TriEverthing/WCH-Link_Tool/WCH-Link-R1-1v1/Hardware/Production/bom.csv

Designator | Footprint | Quantity | Value | LCSC Part #
C1, C19, C3 | 0603 | 3 | 22uF,0603,6.3V
C18, C2, C4, C5, C7 | 0402 | 5 | 0.1uF,0402,25V
D1 | 0402 | 1 | RED
D2 | 0402 | 1 | BLUE
F1 | 0603 | 1 | Fuse
H1, H2, H3, H4 | MountingHole_2.2mm_M2_Pad_Via | 4 | MountingHole_Pad
JP1 | IDC-Header_2x05_P2.54mm_Mid | 1 | Conn_02x05_Odd_Even
L1 | L_Sunlord_SWPA252012S | 1 | 2.2uH
M1, M2, M3 | Fiducial_0.5mm_Mask1mm | 3 | Fiducial
Q1 | SOT-23 | 1 | SI2301
Q2, Q4 | SOT-23 | 2 | SI2302
R1, R2, R5, R6, R7, R9 | 0402 | 6 | 100ohm,0402,5%
R10, R8 | 0402 | 2 | 270ohm,0402,5%
R11 | 0402 | 1 | 4.7kohm,0402,5%
R12 | 0402 | 1 | 470ohm,0402,5%
R13, R15 | 0402 | 2 | 15kohm,0402,5%
R14, R17 | 0402 | 2 | 5.1kohm,0402,5%
R16 | 0402 | 1 | 68kohm,0402,5%
R3, R4 | 0402 | 2 | 1kohm,0402,5%
S2 | SW_Push_SPST_NO_Alps_SKRK | 1 | SW_Push
SW1 | SW_DIP_SPSTx01_Slide_Copal_CHS-01B_W7.62mm_P1.27mm | 1 | SW_DIP_x01
U1 | QFN-28-1EP_4x4mm_P0.4mm_EP2.6x2.6mm_ThermalVias | 1 | CH459F
U2 | SOT-23-5 | 1 | RY3408
USB1 | USB_C_Receptacle_Palconn_UTC16-G | 1 | Type-C-16pin
