TriEverthing/WCH-Link_Tool/WCH-LinkE-R0-1v3/Hardware/Production/bom.csv

Designator | Footprint | Quantity | Value | LCSC Part #
C1, C19, C3 | 0603 | 3 | 22uF,0603,6.3V
C10, C18, C2, C4, C5, C6, C9 | 0402 | 7 | 0.1uF,0402,25V
C7, C8 | 0402 | 2 | 20pF,0402,50V
D1 | 0402 | 1 | RED
D2 | 0402 | 1 | BLUE
H1, H2, H3, H4 | MountingHole_2.2mm_M2_Pad_Via | 4 | MountingHole_Pad
JP1 | IDC-Header_2x05_P2.54mm_Mid | 1 | Conn_02x05_Odd_Even
L1 | L_Sunlord_SWPA252012S | 1 | 2.2uH
M1, M2, M3 | Fiducial_0.5mm_Mask1mm | 3 | Fiducial
R1, R5 | 0402 | 2 | 6.8kohm,0402,5%
R10, R8 | 0402 | 2 | 270ohm,0402,5%
R11, R12 | 0402 | 2 | 4.7kohm,0402,5%
R13, R14, R19, R7, R9 | 0402 | 5 | 100ohm,0402,5%
R15 | 0402 | 1 | 15kohm,0402,5%
R16 | 0402 | 1 | 68kohm,0402,5%
R17, R18 | 0402 | 2 | 5.1kohm,0402,5%
R2, R3, R4 | 0402 | 3 | 1kohm,0402,5%
RT1 | TestPoint_Pad_D0.6 | 1 | TestPoint
S1, S2 | SW_Push_SPST_NO_Alps_SKRK | 2 | SW_Push
U1 | TSSOP-20_4.4x6.5mm_P0.65mm | 1 | ~
U2 | SOT-23-5 | 1 | RY3408
U3, U4 | SOT-23-6 | 2 | CH217A
USB1 | USB_C_Receptacle_Palconn_UTC16-G | 1 | Type-C-16pin
Y1 | Crystal_SMD_3225-4Pin_3.2x2.5mm | 1 | 12HMz,3325
