TriEverthing/WCH-Link_Tool/WCH-LinkW-R0-1v1/Hardware/Production/bom.csv

Designator | Footprint | Quantity | Value | LCSC Part #
C1, C3 | 0603 | 2 | 22uF,0603,6.3V
C10, C11, C12, C2, C4, C5, C6, C9 | 0402 | 8 | 0.1uF,0402,25V
C13, C14 | 0402 | 2 | 1uF,0402,16V
C15, C16 | 0402 | 2 | 1.8pF,0402,50V
D1, D3 | 0402 | 2 | RED
D2 | 0402 | 1 | BLUE
D4, D5 | D_SOD-323 | 2 | 1N5819
E1 | ANT-F-7-2.4G-1.6mmFR4 | 1 | Antenna_PCB
H1, H2 | MountingHole_2.2mm_M2_Pad_Via | 2 | MountingHole_Pad
JP1 | IDC-Header_2x05_P2.54mm_Mid | 1 | Conn_02x05_Odd_Even
L1 | L_Sunlord_SWPA252012S | 1 | 2.2uH
L2 | 0402 | 1 | 1.8nH,0402
M1, M2, M3 | Fiducial_0.5mm_Mask1mm | 3 | Fiducial
R1, R5 | 0402 | 2 | 6.8kohm,0402,5%
R10, R8 | 0402 | 2 | 270ohm,0402,5%
R11, R9 | 0402 | 2 | 5.1kohm,0402,5%
R12, R2, R3, R4, R6 | 0402 | 5 | 1kohm,0402,5%
R15 | 0402 | 1 | 15kohm,0402,5%
R16 | 0402 | 1 | 68kohm,0402,5%
R7 | 0402 | 1 | 100ohm,0402,5%
RN1 | R_Array_Concave_4x0402 | 1 | 100ohm,0402x4,5%
S1, S2 | SW_Push_SPST_NO_Alps_SKRK | 2 | SW_Push
U1 | QFN-28-1EP_4x4mm_P0.4mm_EP2.8x2.8mm_ThermalVias | 1 | CH32V208G
U2 | SOT-23-5 | 1 | RY3408
U3, U4 | SOT-23-6 | 2 | CH217A
USB1 | USB_C_Receptacle_Palconn_UTC16-G | 1 | Type-C-16pin
Y1 | Crystal_SMD_3225-4Pin_3.2x2.5mm | 1 | 32HMz,3325
