TriEverthing/WCH-Link_Tool/WCH-Link-R1-1v1/Hardware/Schmeatic/WCH-Link-R1-1v1.pdf

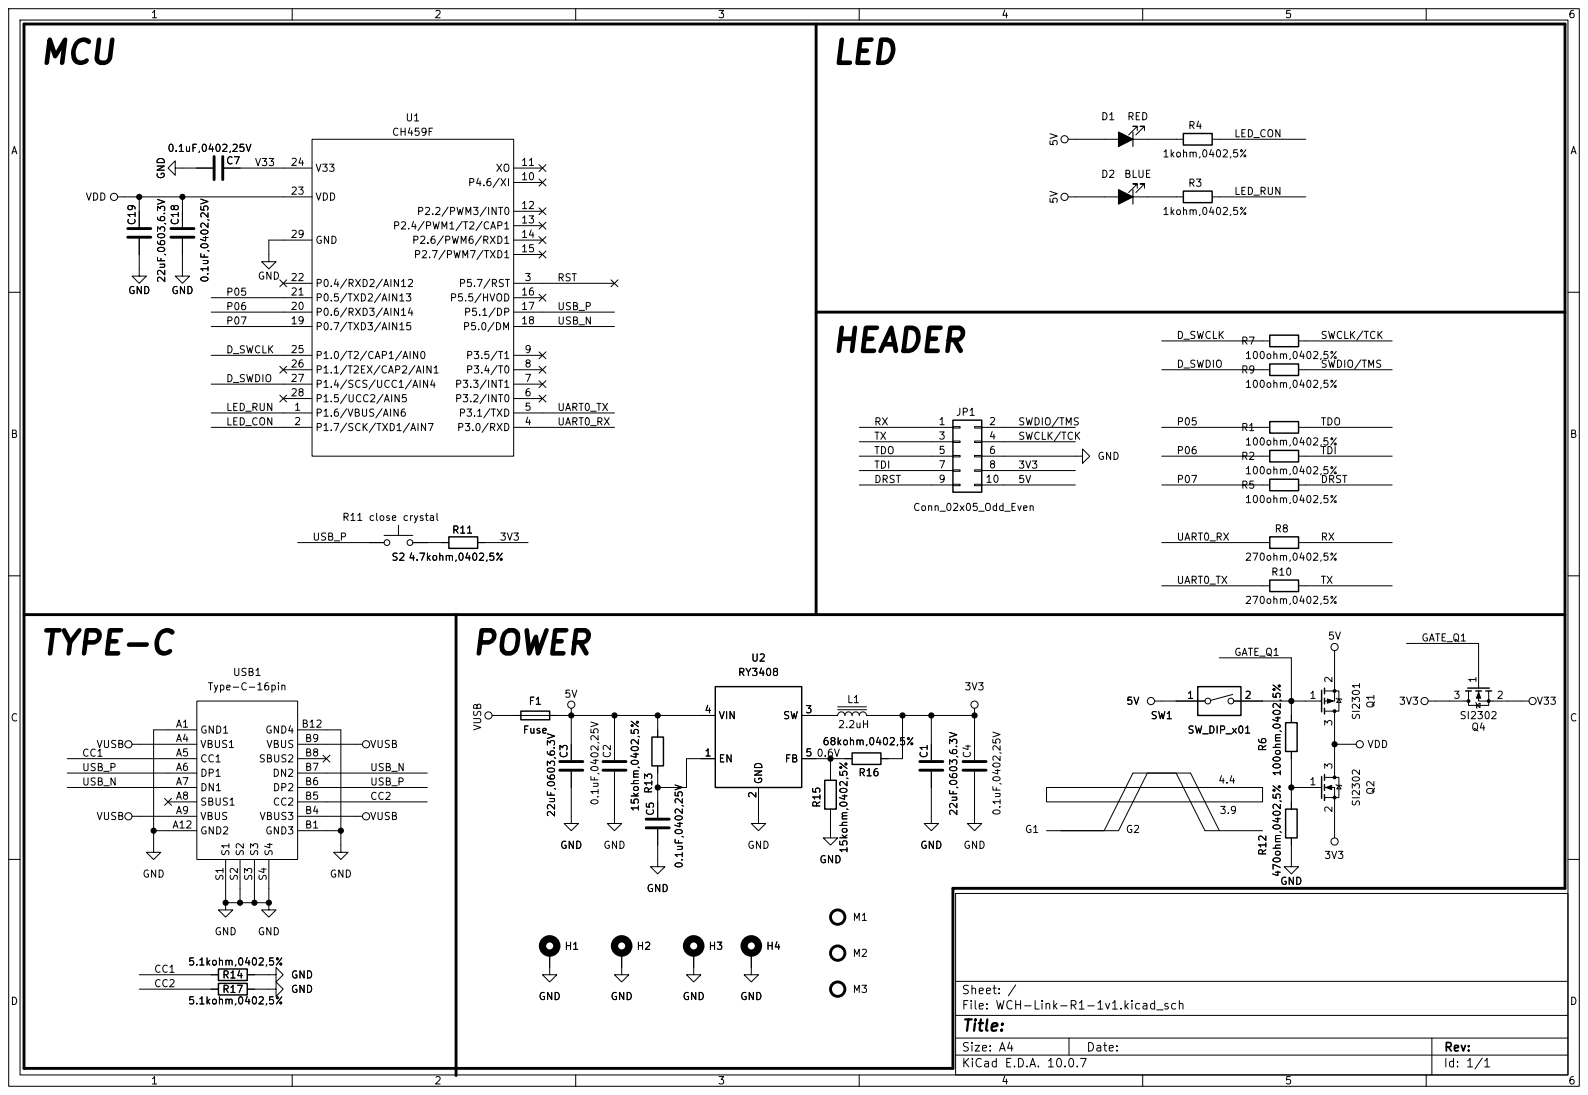
[picture p7: page 1]

TDI SWCLK/TCK GATE_Q1 GATE_Q1 UART0_RX UART0_TX DRST TXRX

Type-C-16pin

Size: A4 | Rev:
KiCad E.D.A. 10.0.7 | Id: 1/1
