TriEverthing/WCH-Link_Tool/WCH-LinkW-R0-1v1/Hardware/Schmeatic/WCH-LinkW-R0-1v1.pdf

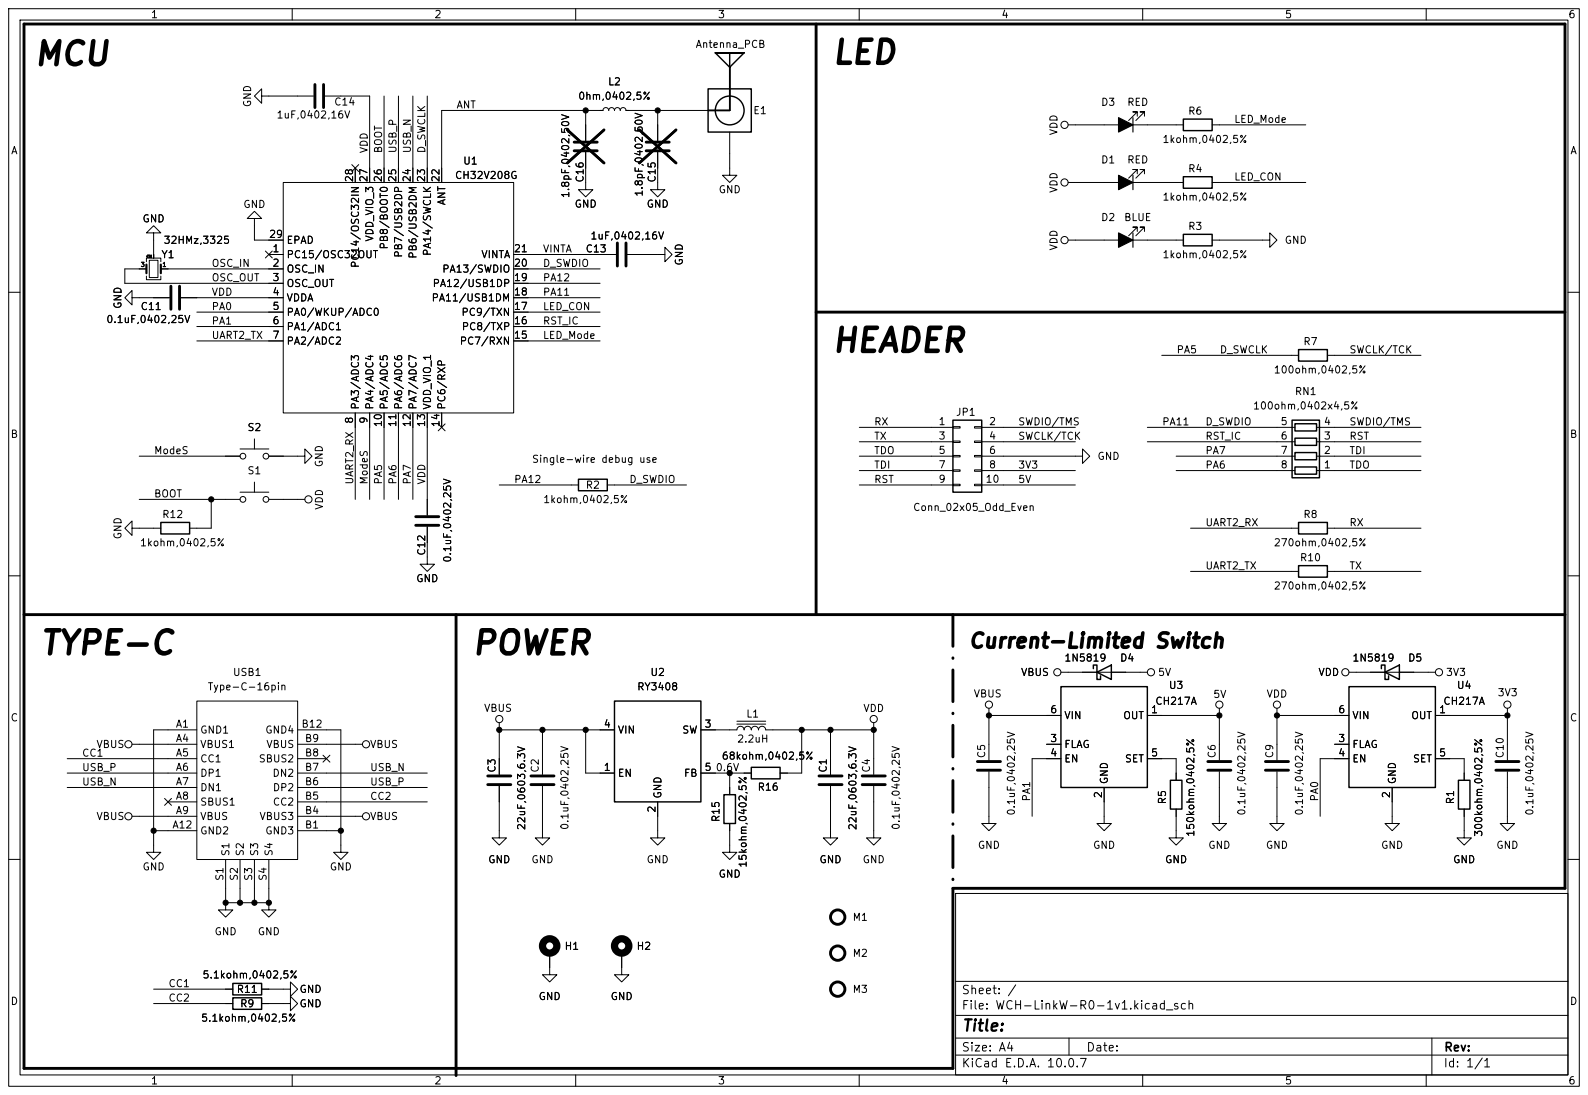
[picture p8: page 1]

Single-wire debug use MCU

PC7/RXN 15 PC8/TXP 16 PC9/TXN 17 PA11/USB1DM 18 PA12/USB1DP 19 PA13/SWDIO 20 VINTA 21 ANT 22 PA14/SWCLK 23 PB6/USB2DM 24 PB7/USB2DP 25 PB8/BOOT0 26 VDD_VIO_3 27 PC14/OSC32IN 28
UART2_TX CC1

Size: A4 | Rev:
KiCad E.D.A. 10.0.7 | Id: 1/1
