TriEverthing/WCH-Link_Tool/WCH-DAPLink-R0-2v0/Hardware/Schmeatic/WCH-DAPLink-R0-2v0.pdf

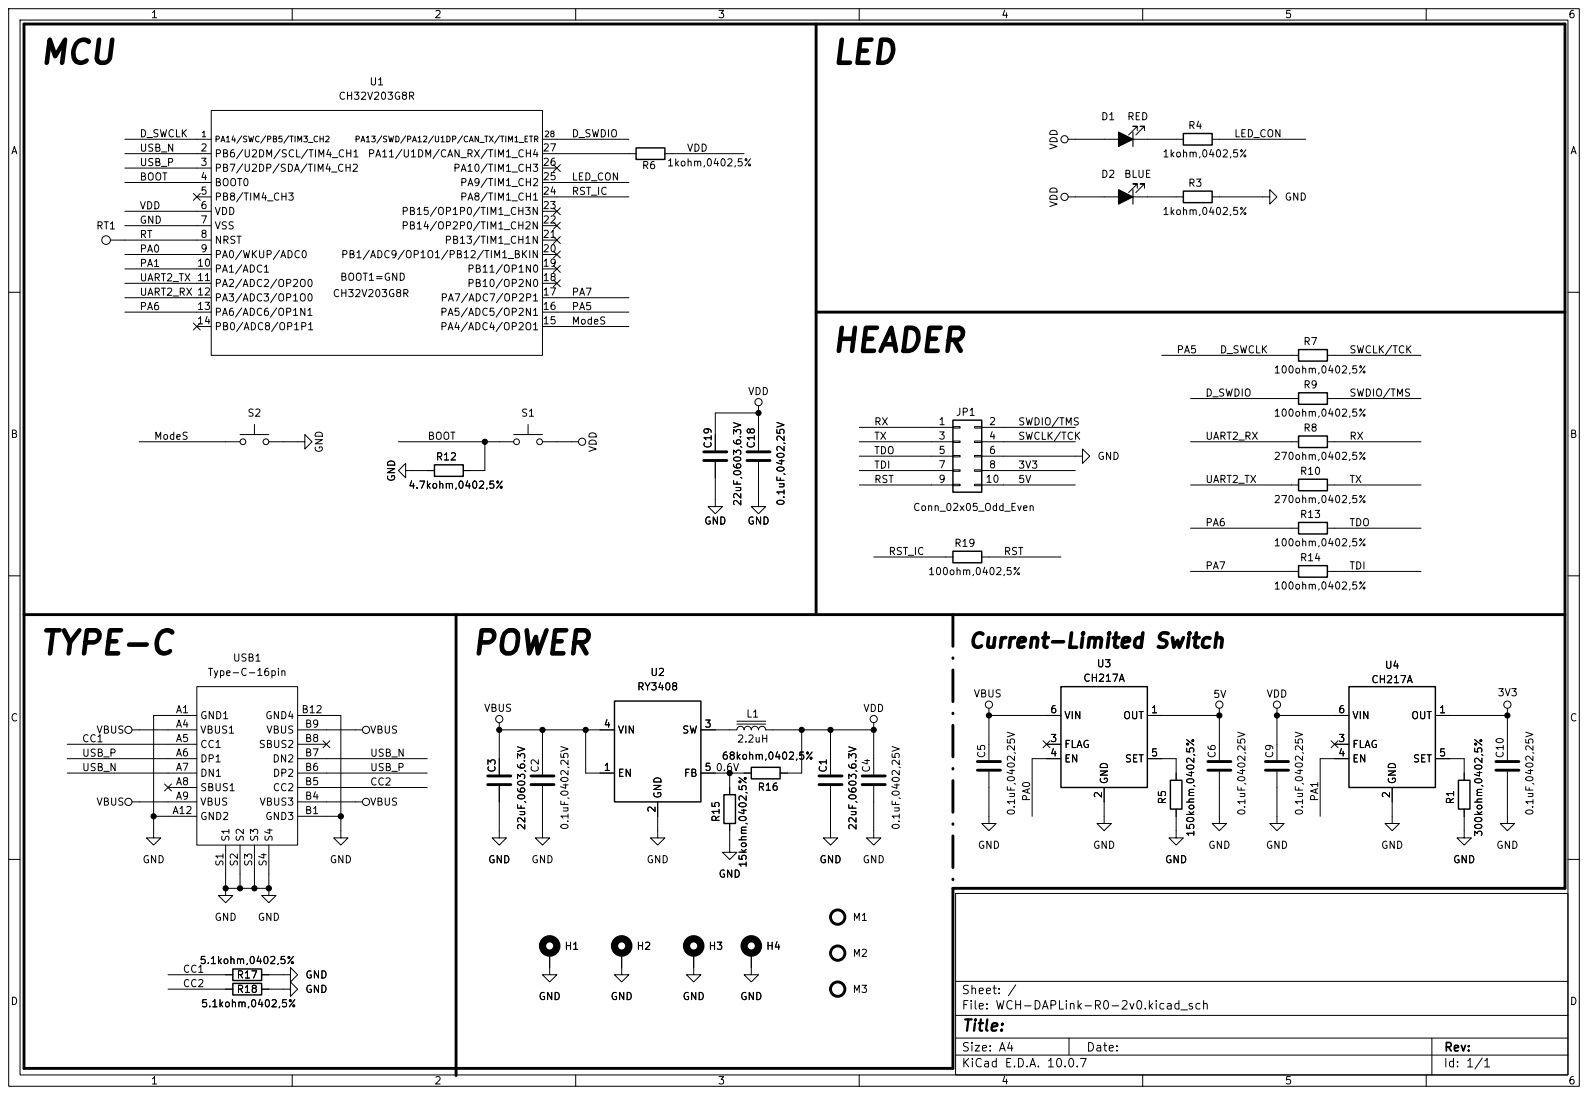
[picture p9: page 1]

Size: A4 | Rev:
KiCad E.D.A. 10.0.7 | Id: 1/1
