TriEverthing/WCH-Link_Tool/WCH-LinkE-R0-1v3/Hardware/Schmeatic/WCH-LinkE-R0-1v3.pdf

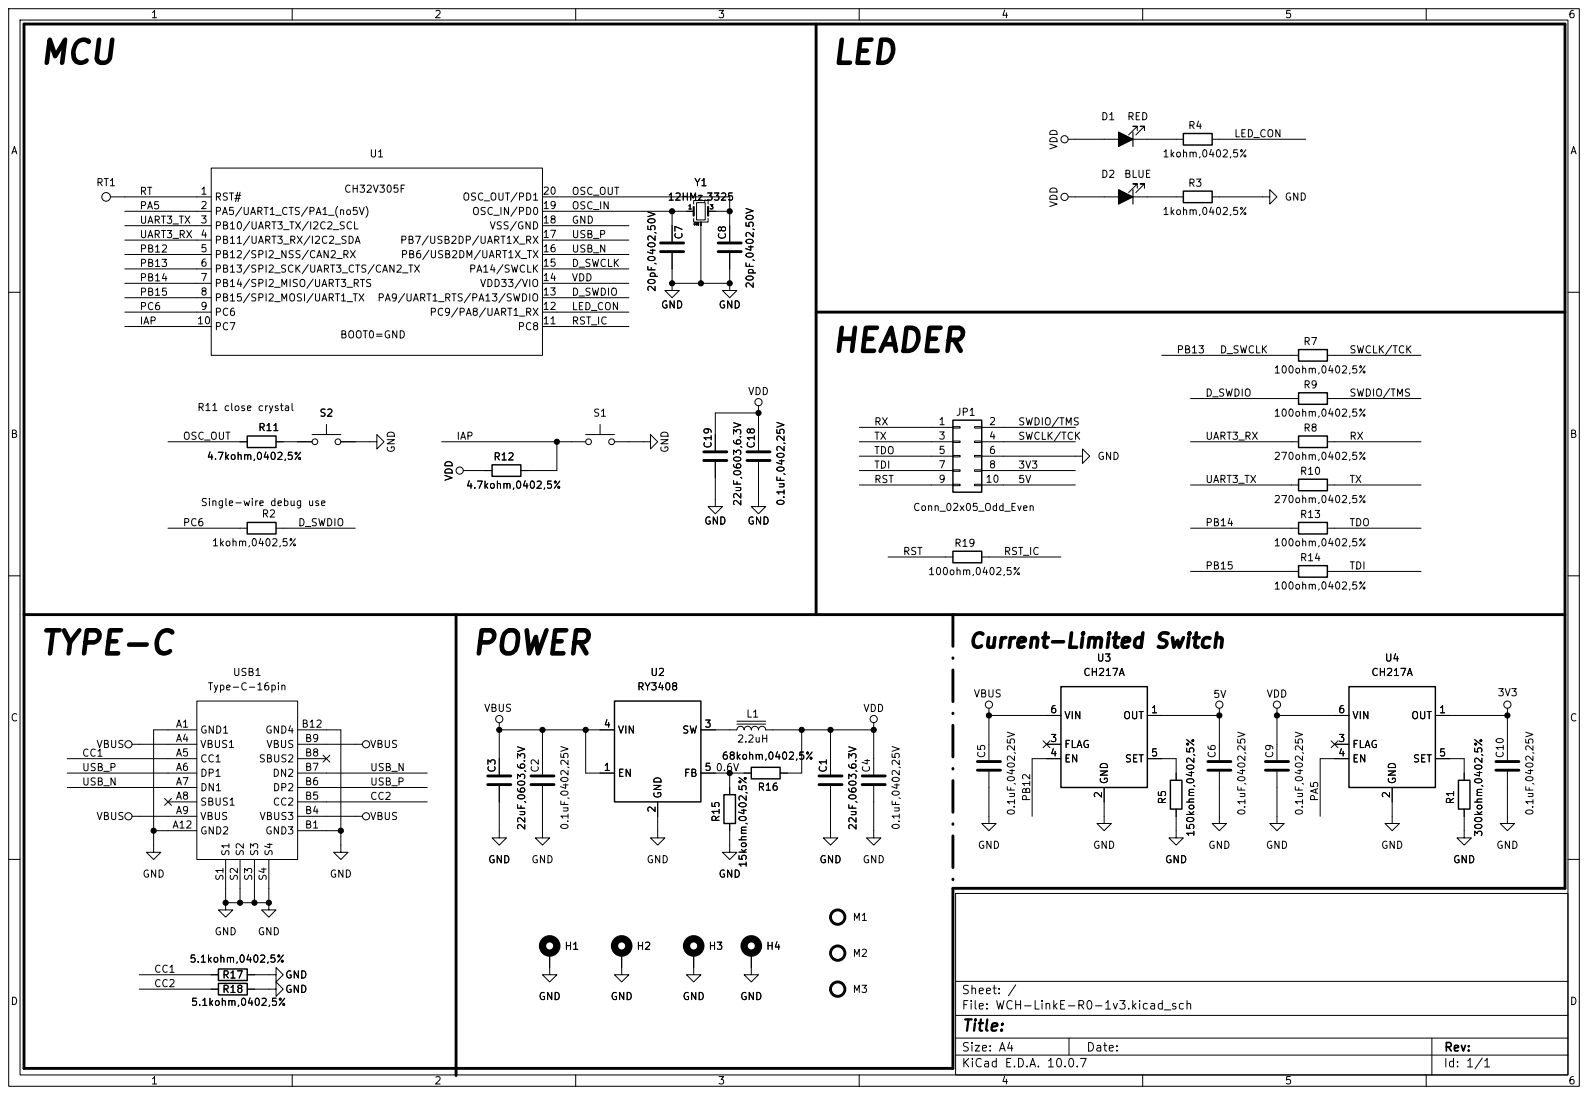
[picture p10: page 1]

Single-wire debug use TYPE-C

Size: A4 | Rev:
KiCad E.D.A. 10.0.7 | Id: 1/1
