TriEverthing/WCH-Link_Tool/(commit log)

2026-10-15 Add WCH-DAPLink-R0-2v0 Files
    [WCH-DAPLink-R0-2v0.brd, WCH-LinkE-R0-1v3.brd, bom.csv, designators.csv, positions.csv]
2026-10-18 Modified WCH-LinkW-R0-1v1 Antenna files
